KRISCHOMAT/matrix-sq/schematics/matrix-sq-v1.kicad_pcb

## KiCad design schematics/matrix-sq-v1.kicad_pcb (2022-08-06)

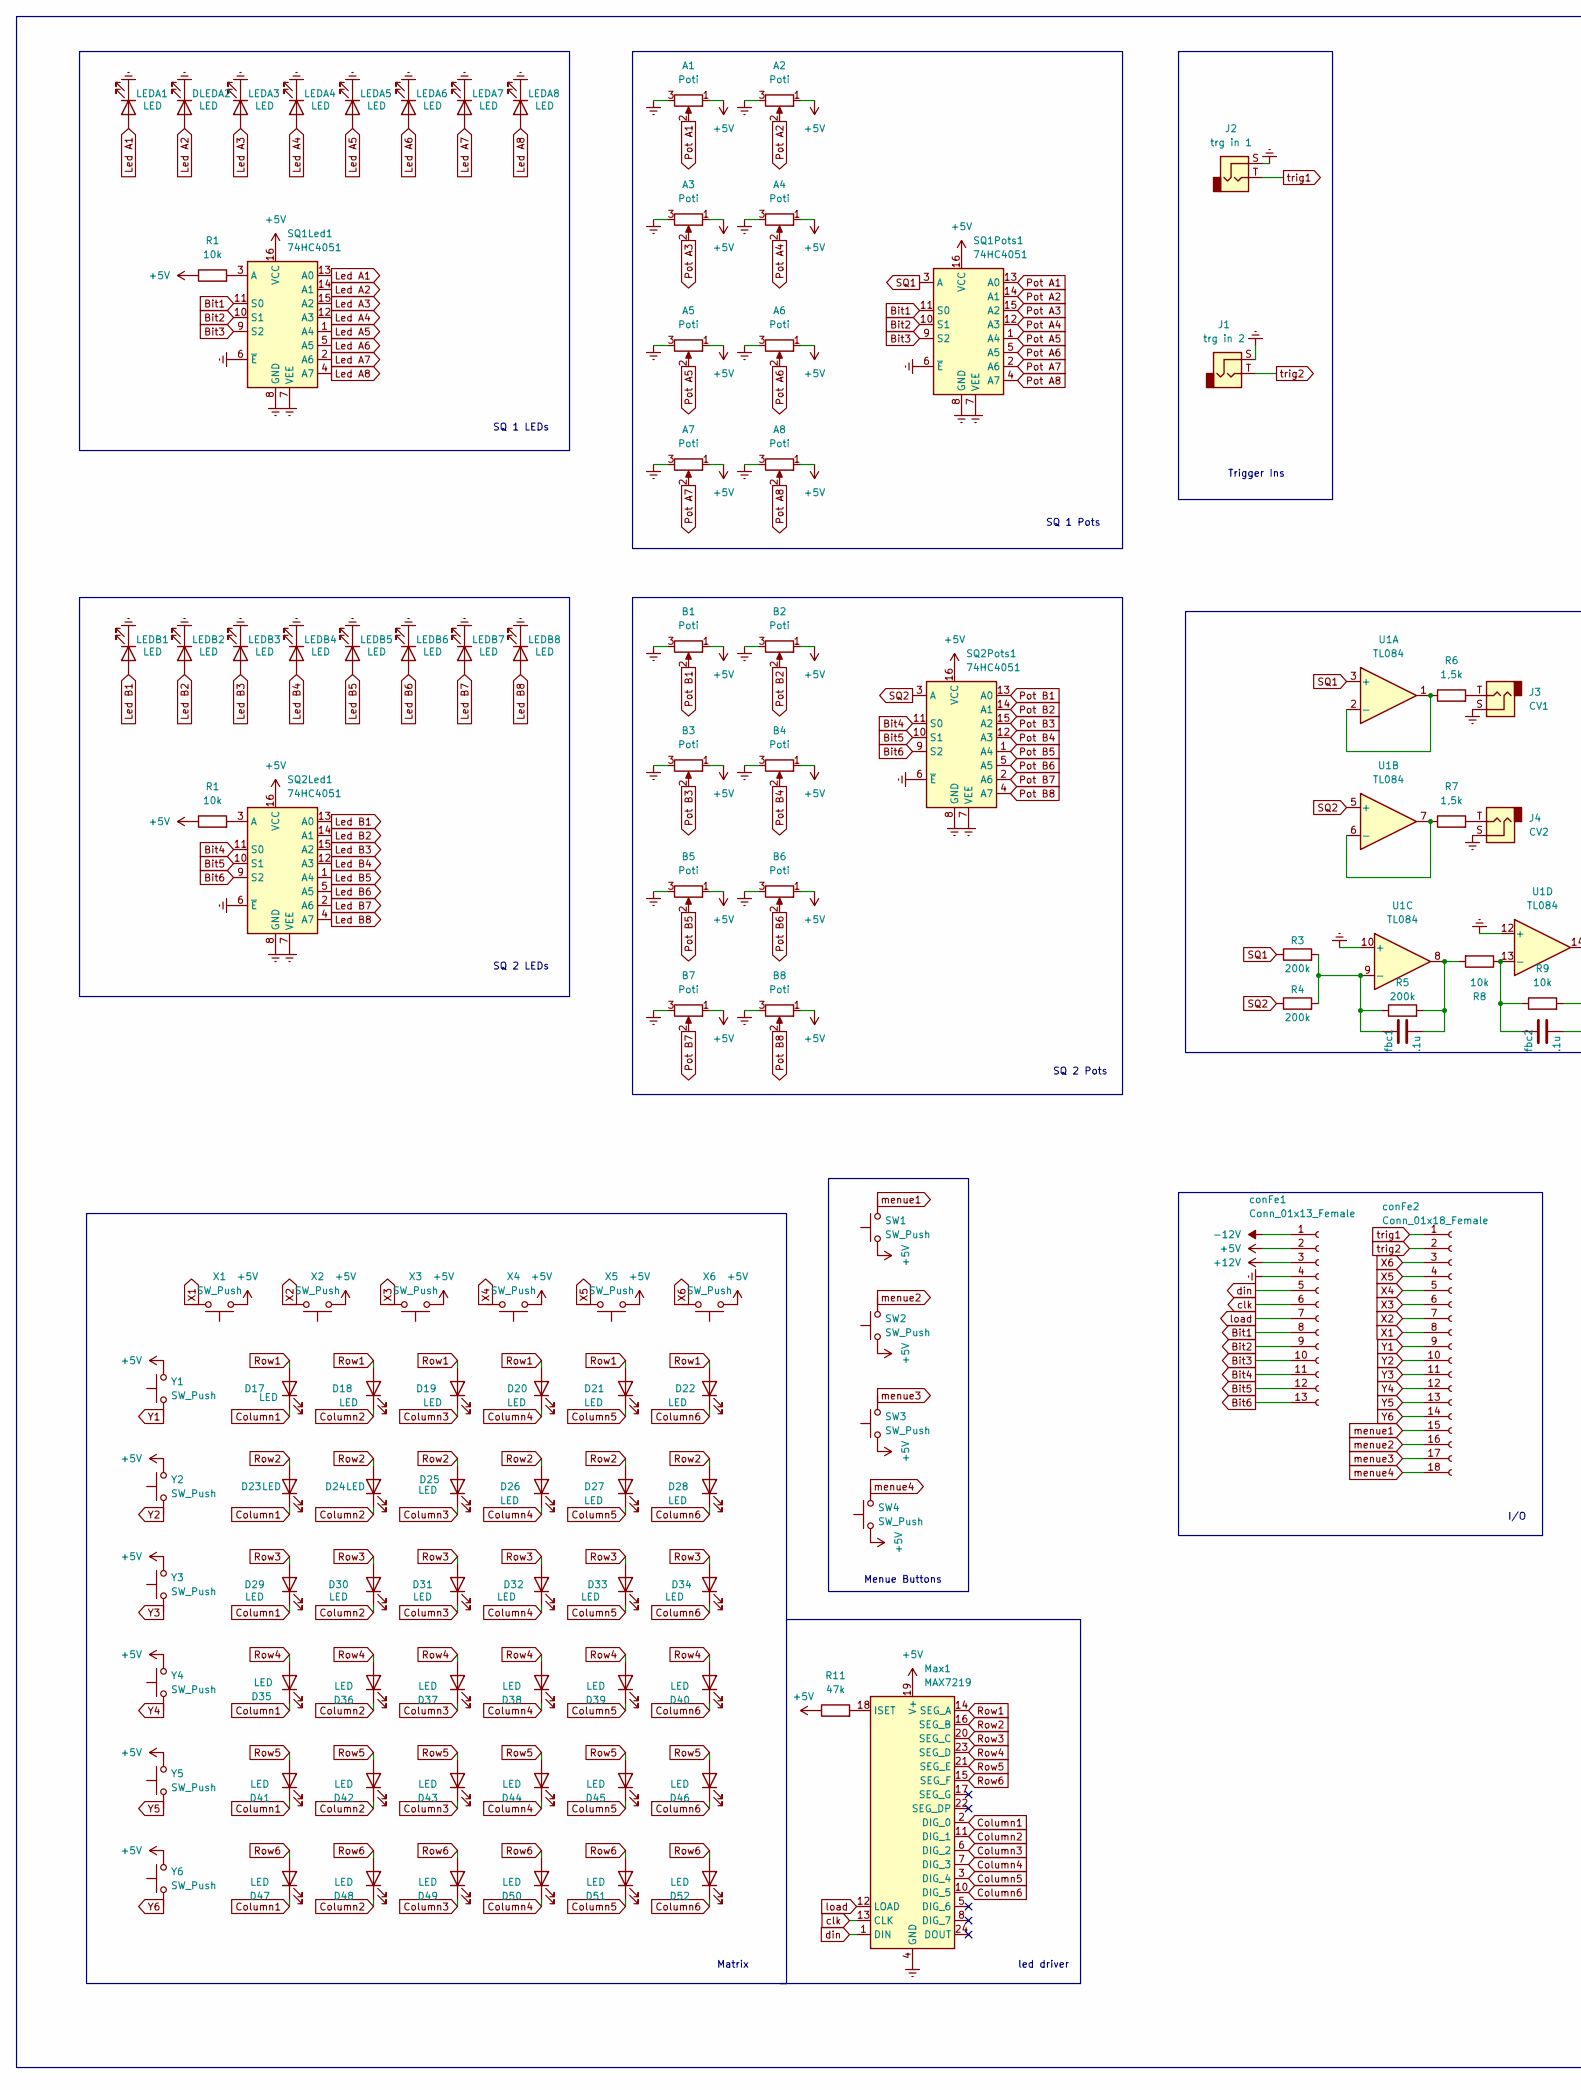
[picture p1: schematic matrix-sq-v1.kicad_sch, part in row 1, column 1]

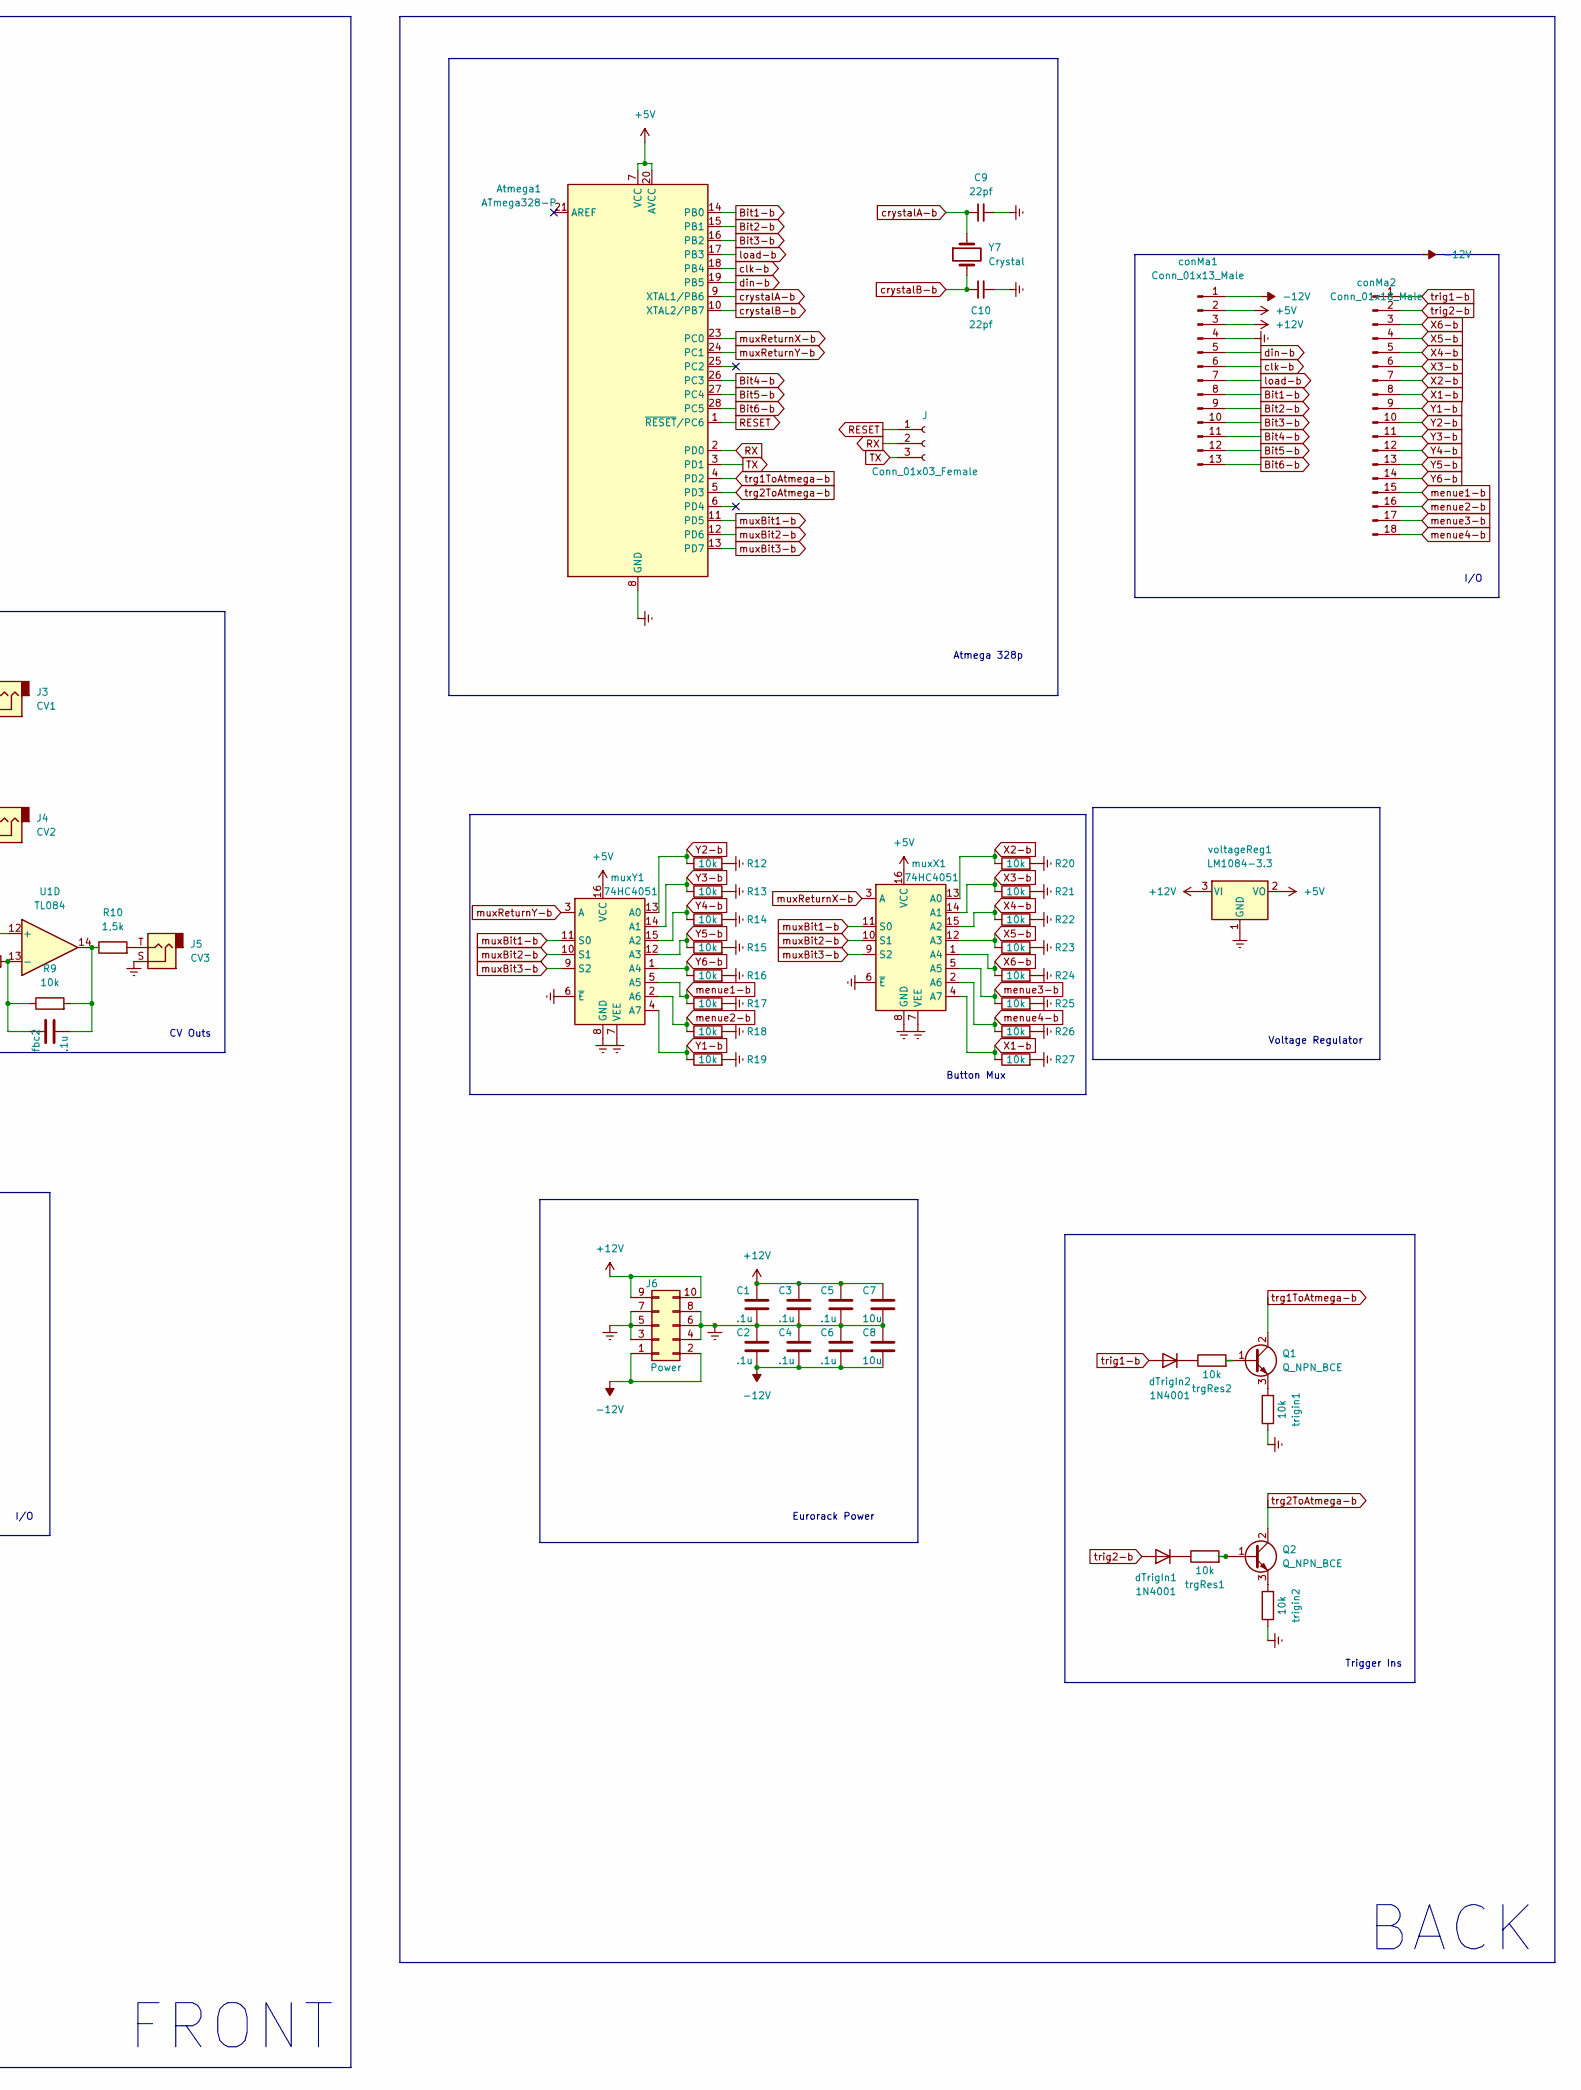
[picture p2: schematic matrix-sq-v1.kicad_sch, part in row 1, column 2]

Parts:
A1, A2, A3, A4, A5, A6, A7, A8: Poti; Potentiometer_Alpha_RD901F-40-00D_Single_Vertical
Atmega1: ATmega328-P; DIP-28_W7.62mm
B1, B2, B3, B4, B5, B6, B7, B8: Poti; Potentiometer_Alpha_RD901F-40-00D_Single_Vertical
C1, C2, C3, C4, C5, C6: .1u; C_Disc_D3.0mm_W1.6mm_P2.50mm
C7, C8: 10u; C_Disc_D3.0mm_W1.6mm_P2.50mm
C9, C10: 22pf; C_Disc_D3.0mm_W1.6mm_P2.50mm
D17, D18, D19, D20, D21, D22, D23, D24, D25, D26, D27, D28, D29, D30, D31, D32, D33, D34, D35, D36, D37, D38, D39, D40, D41, D42, D43, D44, D45, D46, D47, D48, D49, D50, D51, D52: LED; LED_D3.0mm
DLEDA2: LED; LED_D3.0mm
J: Conn_01x03_Female; PinHeader_1x03_P2.54mm_Vertical
J1: trg in 2; Jack_3.5mm_QingPu_WQP-PJ398SM_Vertical_CircularHoles
J2: trg in 1; Jack_3.5mm_QingPu_WQP-PJ398SM_Vertical_CircularHoles
J3: CV1; Jack_3.5mm_QingPu_WQP-PJ398SM_Vertical_CircularHoles
J4: CV2; Jack_3.5mm_QingPu_WQP-PJ398SM_Vertical_CircularHoles
J5: CV3; Jack_3.5mm_QingPu_WQP-PJ398SM_Vertical_CircularHoles
J6: Power; PinHeader_2x05_P2.54mm_Vertical
LEDA1, LEDA3, LEDA4, LEDA5, LEDA6, LEDA7, LEDA8: LED; LED_D3.0mm
LEDB1, LEDB2, LEDB3, LEDB4, LEDB5, LEDB6, LEDB7, LEDB8: LED; LED_D3.0mm
Max1: MAX7219; DIP-24_W7.62mm
Q1, Q2: Q_NPN_BCE; TO-92Flat
R1, R12: R600; R_Axial_DIN0207_L6.3mm_D2.5mm_P7.62mm_Horizontal
R3, R4, R5: 200k; R_Axial_DIN0207_L6.3mm_D2.5mm_P7.62mm_Horizontal
R6, R7, R10: 1,5k; R_Axial_DIN0207_L6.3mm_D2.5mm_P7.62mm_Horizontal
R8, R9, R13, R14, R15, R16, R17, R18, R19, R20, R21, R22, R23, R24, R25, R26, R27: 10k; R_Axial_DIN0207_L6.3mm_D2.5mm_P7.62mm_Horizontal
R11: 47k; R_Axial_DIN0207_L6.3mm_D2.5mm_P7.62mm_Horizontal
SQ1Led1, SQ1Pots1, SQ2Led1, SQ2Pots1: 74HC4051; DIP-16_W7.62mm_Socket
SW1, SW2, SW3, SW4: SW_Push; push_button
U1: TL084; DIP-14_W7.62mm_Socket
X1, X2, X3, X4, X5, X6: SW_Push; push_button
Y1, Y2, Y3, Y4, Y5, Y6: SW_Push; push_button
Y7: Crystal; Crystal_HC18-U_Vertical
conFe1: Conn_01x13_Female; PinHeader_1x13_P2.54mm_Vertical
conFe2: Conn_01x18_Female; PinHeader_1x18_P2.54mm_Vertical
conMa1: Conn_01x13_Male; PinHeader_1x13_P2.54mm_Vertical
conMa2: Conn_01x18_Male; PinSocket_1x18_P2.54mm_Vertical
dTrigIn1, dTrigIn2: 1N4001; D_DO-41_SOD81_P10.16mm_Horizontal
fbc1, fbc2: .1u; C_Disc_D3.0mm_W1.6mm_P2.50mm
muxX1: 74HC4051; DIP-16_W7.62mm_Socket
muxY1: 74HC4051; DIP-16_W7.62mm_Socket
trgRes1, trgRes2: 10k; R_Axial_DIN0207_L6.3mm_D2.5mm_P7.62mm_Horizontal
trigin1, trigin2: 10k; R_Axial_DIN0207_L6.3mm_D2.5mm_P7.62mm_Horizontal
voltageReg1: LM1084-3.3; TO-220-3_Vertical

Connections:
+5V: A1.1, A2.1, A3.1, A4.1, A5.1, A6.1, A7.1, A8.1, Atmega1.7 (VCC), Atmega1.20 (AVCC), B1.1, B2.1, B3.1, B4.1, B5.1, B6.1, B7.1, B8.1, Max1.19 (V+), R1.1, R11.1, SQ1Led1.16 (VCC), SQ1Pots1.16 (VCC), SQ2Led1.16 (VCC), SQ2Pots1.16 (VCC), SW1.1, SW2.1, SW3.1, SW4.1, X1.1, X2.1, X3.1, X4.1, X5.1, X6.1, Y1.2, Y2.2, Y3.2, Y4.2, Y5.2, Y6.2, conFe1.2, conMa1.2, muxX1.16 (VCC), muxY1.16 (VCC), voltageReg1.2 (VO); also elsewhere on the board
+12V: C1.1, C3.1, C5.1, C7.1, J6.9, J6.10, conFe1.3, conMa1.3, voltageReg1.3 (VI)
-12V: C2.2, C4.2, C6.2, C8.2, J6.1, J6.2, conFe1.1, conMa1.1
Bit1: SQ1Led1.11 (S0), SQ1Pots1.11 (S0), conFe1.8
Bit1-b: Atmega1.14 (PB0), conMa1.8
Bit2: SQ1Led1.10 (S1), SQ1Pots1.10 (S1), conFe1.9
Bit2-b: Atmega1.15 (PB1), conMa1.9
Bit3: SQ1Led1.9 (S2), SQ1Pots1.9 (S2), conFe1.10
Bit3-b: Atmega1.16 (PB2), conMa1.10
Bit4: SQ2Led1.11 (S0), SQ2Pots1.11 (S0), conFe1.11
Bit4-b: Atmega1.26 (PC3), conMa1.11
Bit5: SQ2Led1.10 (S1), SQ2Pots1.10 (S1), conFe1.12
Bit5-b: Atmega1.27 (PC4), conMa1.12
Bit6: SQ2Led1.9 (S2), SQ2Pots1.9 (S2), conFe1.13
Bit6-b: Atmega1.28 (PC5), conMa1.13
Column1: D17.1 (K), D23.1 (K), D29.1 (K), D35.1 (K), D41.1 (K), D47.1 (K), Max1.2 (DIG_0)
Column2: D18.1 (K), D24.1 (K), D30.1 (K), D36.1 (K), D42.1 (K), D48.1 (K), Max1.11 (DIG_1)
Column3: D19.1 (K), D25.1 (K), D31.1 (K), D37.1 (K), D43.1 (K), D49.1 (K), Max1.6 (DIG_2)
Column4: D20.1 (K), D26.1 (K), D32.1 (K), D38.1 (K), D44.1 (K), D50.1 (K), Max1.7 (DIG_3)
Column5: D21.1 (K), D27.1 (K), D33.1 (K), D39.1 (K), D45.1 (K), D51.1 (K), Max1.3 (DIG_4)
Column6: D22.1 (K), D28.1 (K), D34.1 (K), D40.1 (K), D46.1 (K), D52.1 (K), Max1.10 (DIG_5)
Earth: A1.3, A2.3, A3.3, A4.3, A5.3, A6.3, A7.3, A8.3, Atmega1.8 (GND), Atmega1.22 (GND), B1.3, B2.3, B3.3, B4.3, B5.3, B6.3, B7.3, B8.3, C1.2, C2.1, C3.2, C4.1, C5.2, C6.1, C7.2, C8.1, C9.2, C10.2, DLEDA2.1 (K), J1.S, J2.S, J3.S, J4.S, J5.S, J6.3, J6.4, J6.5, J6.6, J6.7, J6.8, LEDA1.1 (K), LEDA3.1 (K), LEDA4.1 (K), LEDA5.1 (K), LEDA6.1 (K), LEDA7.1 (K), LEDA8.1 (K), LEDB1.1 (K), LEDB2.1 (K), LEDB3.1 (K), LEDB4.1 (K), LEDB5.1 (K), LEDB6.1 (K), LEDB7.1 (K), LEDB8.1 (K), Max1.4 (GND), Max1.9 (GND), R12.2, R13.2, R14.2, R15.2, R16.2, R17.2, R18.2, R19.2, R20.2, R21.2, R22.2, R23.2, R24.2, R25.2, R26.2, R27.2, SQ1Led1.6 (~E), SQ1Led1.7 (VEE), SQ1Led1.8 (GND), SQ1Pots1.6 (~E), SQ1Pots1.7 (VEE), SQ1Pots1.8 (GND), SQ2Led1.6 (~E), SQ2Led1.7 (VEE), SQ2Led1.8 (GND), SQ2Pots1.6 (~E), SQ2Pots1.7 (VEE), SQ2Pots1.8 (GND), U1.10 (+), U1.12 (+), conFe1.4, conMa1.4, muxX1.6 (~E), muxX1.7 (VEE), muxX1.8 (GND), muxY1.6 (~E), muxY1.7 (VEE), muxY1.8 (GND), trigin1.1, trigin2.1, voltageReg1.1 (GND)
Led A1: LEDA1.2 (A), SQ1Led1.13 (A0)
Led A2: DLEDA2.2 (A), SQ1Led1.14 (A1)
Led A3: LEDA3.2 (A), SQ1Led1.15 (A2)
Led A4: LEDA4.2 (A), SQ1Led1.12 (A3)
Led A5: LEDA5.2 (A), SQ1Led1.1 (A4)
Led A6: LEDA6.2 (A), SQ1Led1.5 (A5)
Led A7: LEDA7.2 (A), SQ1Led1.2 (A6)
Led A8: LEDA8.2 (A), SQ1Led1.4 (A7)
Led B1: LEDB1.2 (A), SQ2Led1.13 (A0)
Led B2: LEDB2.2 (A), SQ2Led1.14 (A1)
Led B3: LEDB3.2 (A), SQ2Led1.15 (A2)
Led B4: LEDB4.2 (A), SQ2Led1.12 (A3)
Led B5: LEDB5.2 (A), SQ2Led1.1 (A4)
Led B6: LEDB6.2 (A), SQ2Led1.5 (A5)
Led B7: LEDB7.2 (A), SQ2Led1.2 (A6)
Led B8: LEDB8.2 (A), SQ2Led1.4 (A7)
unnamed: J3.T, R6.2
unnamed: J4.T, R7.2
unnamed: J5.T, R10.2
unnamed 41: Max1.18 (ISET), R11.2; also elsewhere on the board
unnamed: Q1.1 (B), trgRes2.2
unnamed: Q1.3 (E), trigin1.2
unnamed: Q2.1 (B), trgRes1.2
unnamed: Q2.3 (E), trigin2.2
unnamed: R3.2, R4.2, R5.1, U1.9 (-), fbc1.1
unnamed: R5.2, R8.2, U1.8, fbc1.2
unnamed: R6.1, U1.1, U1.2 (-)
unnamed: R7.1, U1.6 (-), U1.7
unnamed: R8.1, R9.1, U1.13 (-), fbc2.1
unnamed: R9.2, R10.1, U1.14, fbc2.2
unnamed: dTrigIn1.1 (K), trgRes1.1
unnamed: dTrigIn2.1 (K), trgRes2.1
Pot A1: A1.2, SQ1Pots1.13 (A0)
Pot A2: A2.2, SQ1Pots1.14 (A1)
Pot A3: A3.2, SQ1Pots1.15 (A2)
Pot A4: A4.2, SQ1Pots1.12 (A3)
Pot A5: A5.2, SQ1Pots1.1 (A4)
Pot A6: A6.2, SQ1Pots1.5 (A5)
Pot A7: A7.2, SQ1Pots1.2 (A6)
Pot A8: A8.2, SQ1Pots1.4 (A7)
Pot B1: B1.2, SQ2Pots1.13 (A0)
Pot B2: B2.2, SQ2Pots1.14 (A1)
Pot B3: B3.2, SQ2Pots1.15 (A2)
Pot B4: B4.2, SQ2Pots1.12 (A3)
Pot B5: B5.2, SQ2Pots1.1 (A4)
Pot B6: B6.2, SQ2Pots1.5 (A5)
Pot B7: B7.2, SQ2Pots1.2 (A6)
Pot B8: B8.2, SQ2Pots1.4 (A7)
RESET: Atmega1.1 (~RESET/PC6), J.1
RX: Atmega1.2 (PD0), J.2
Row1: D17.2 (A), D18.2 (A), D19.2 (A), D20.2 (A), D21.2 (A), D22.2 (A), Max1.14 (SEG_A)
Row2: D23.2 (A), D24.2 (A), D25.2 (A), D26.2 (A), D27.2 (A), D28.2 (A), Max1.16 (SEG_B)
Row3: D29.2 (A), D30.2 (A), D31.2 (A), D32.2 (A), D33.2 (A), D34.2 (A), Max1.20 (SEG_C)
Row4: D35.2 (A), D36.2 (A), D37.2 (A), D38.2 (A), D39.2 (A), D40.2 (A), Max1.23 (SEG_D)
Row5: D41.2 (A), D42.2 (A), D43.2 (A), D44.2 (A), D45.2 (A), D46.2 (A), Max1.21 (SEG_E)
Row6: D47.2 (A), D48.2 (A), D49.2 (A), D50.2 (A), D51.2 (A), D52.2 (A), Max1.15 (SEG_F)
SQ1: R3.1, SQ1Pots1.3 (A), U1.3 (+)
SQ2: R4.1, SQ2Pots1.3 (A), U1.5 (+)
TX: Atmega1.3 (PD1), J.3
X1: X1.2, conFe2.8
X1-b: R27.1, conMa2.8, muxX1.4 (A7)
X2: X2.2, conFe2.7
X2-b: R20.1, conMa2.7, muxX1.13 (A0)
X3: X3.2, conFe2.6
X3-b: R21.1, conMa2.6, muxX1.14 (A1)
X4: X4.2, conFe2.5
X4-b: R22.1, conMa2.5, muxX1.15 (A2)
X5: X5.2, conFe2.4
X5-b: R23.1, conMa2.4, muxX1.12 (A3)
X6: X6.2, conFe2.3
X6-b: R24.1, conMa2.3, muxX1.1 (A4)
Y1: Y1.1, conFe2.9
Y1-b: R19.1, conMa2.9, muxY1.4 (A7)
Y2: Y2.1, conFe2.10
Y2-b: R12.1, conMa2.10, muxY1.13 (A0)
Y3: Y3.1, conFe2.11
Y3-b: R13.1, conMa2.11, muxY1.14 (A1)
Y4: Y4.1, conFe2.12
Y4-b: R14.1, conMa2.12, muxY1.15 (A2)
Y5: Y5.1, conFe2.13
Y5-b: R15.1, conMa2.13, muxY1.12 (A3)
Y6: Y6.1, conFe2.14
Y6-b: R16.1, conMa2.14, muxY1.1 (A4)
clk: Max1.13 (CLK), conFe1.6
clk-b: Atmega1.18 (PB4), conMa1.6
crystalA-b: Atmega1.9 (XTAL1/PB6), C9.1, Y7.1
crystalB-b: Atmega1.10 (XTAL2/PB7), C10.1, Y7.2
din: Max1.1 (DIN), conFe1.5
din-b: Atmega1.19 (PB5), conMa1.5
load: Max1.12 (LOAD), conFe1.7
load-b: Atmega1.17 (PB3), conMa1.7
menue1: SW1.2, conFe2.15
menue1-b: R17.1, conMa2.15, muxY1.5 (A5)
menue2: SW2.2, conFe2.16
menue2-b: R18.1, conMa2.16, muxY1.2 (A6)
menue3: SW3.2, conFe2.17
menue3-b: R25.1, conMa2.17, muxX1.5 (A5)
menue4: SW4.2, conFe2.18
menue4-b: R26.1, conMa2.18, muxX1.2 (A6)
muxBit1-b: Atmega1.11 (PD5), muxX1.11 (S0), muxY1.11 (S0)
muxBit2-b: Atmega1.12 (PD6), muxX1.10 (S1), muxY1.10 (S1)
muxBit3-b: Atmega1.13 (PD7), muxX1.9 (S2), muxY1.9 (S2)
muxReturnX-b: Atmega1.23 (PC0), muxX1.3 (A)
muxReturnY-b: Atmega1.24 (PC1), muxY1.3 (A)
trg1ToAtmega-b: Atmega1.4 (PD2), Q1.2 (C)
trg2ToAtmega-b: Atmega1.5 (PD3), Q2.2 (C)
trig1: J2.T, conFe2.1
trig1-b: conMa2.1, dTrigIn2.2 (A)
trig2: J1.T, conFe2.2
trig2-b: conMa2.2, dTrigIn1.2 (A)

Notes on the sheet:
BACK
Voltage Regulator
SQ 2 Pots
led driver
Trigger Ins
FRONT
SQ 1 Pots
Eurorack Power
SQ 2 LEDs
Matrix
Atmega 328p
Button Mux
I/O
CV Outs
Menue Buttons
SQ 1 LEDs

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
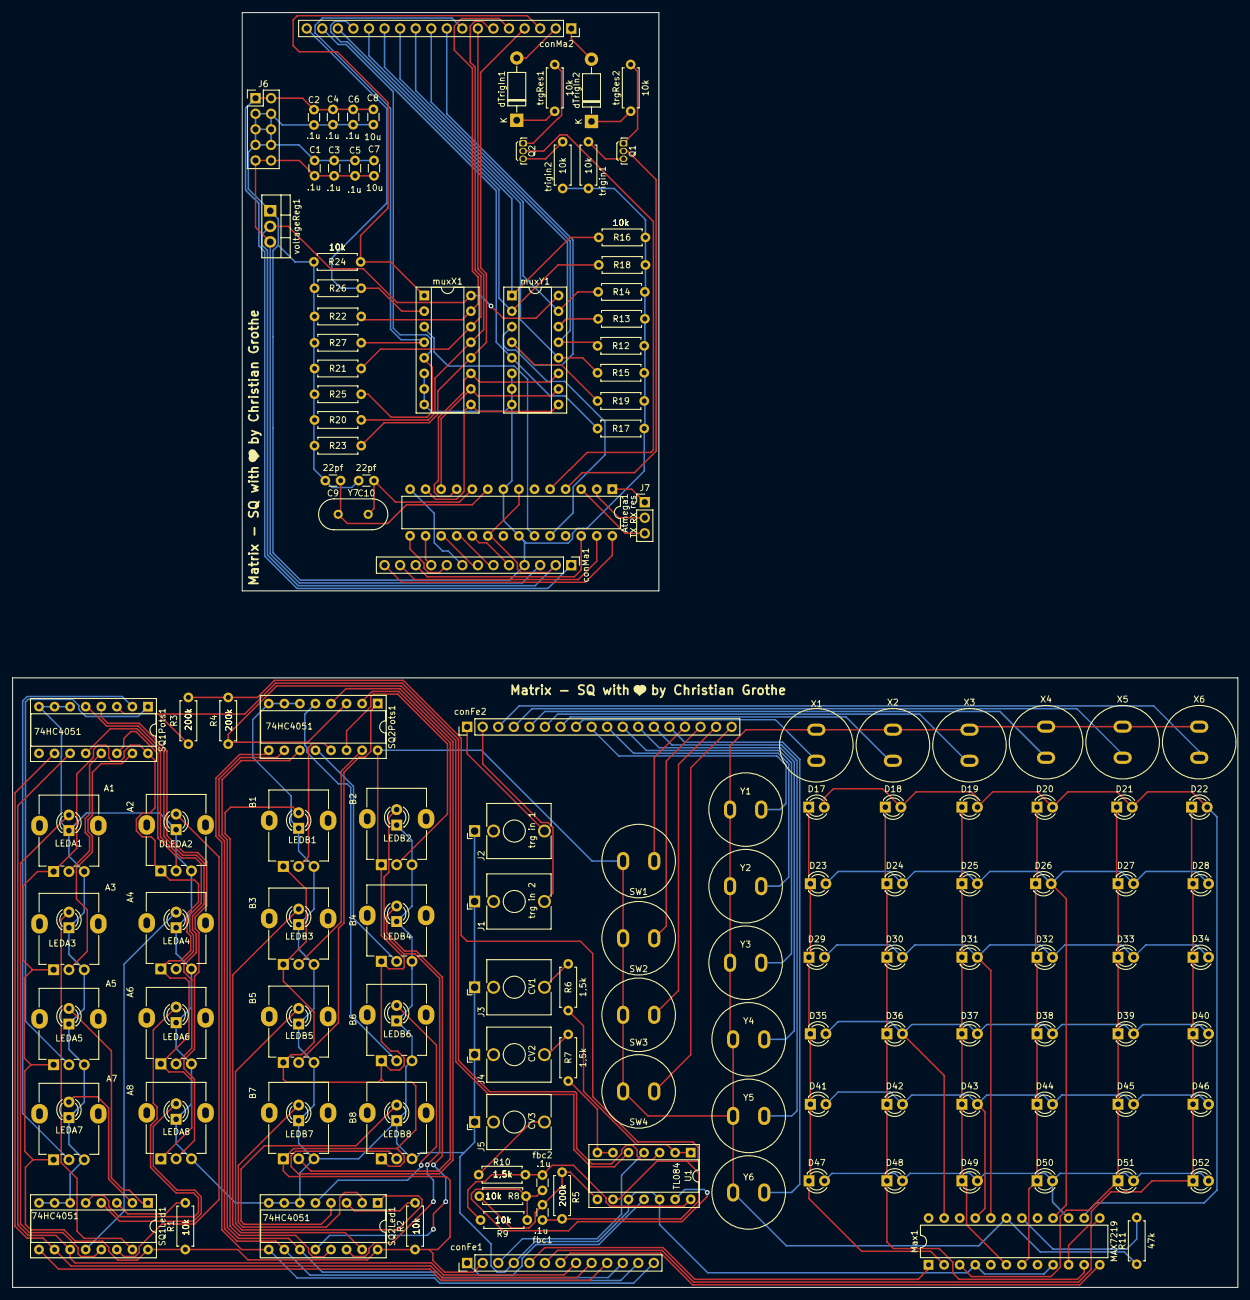
[picture p3: board matrix-sq-v1.kicad_pcb from above]

Board: 2 copper layers, 200.0 x 208.1 mm, 153 parts (0 on the bottom side), 134 nets.

Other parts of the board:
R1#2: R600; R_Axial_DIN0207_L6.3mm_D2.5mm_P7.62mm_Horizontal
R?: 47k; R_Axial_DIN0207_L6.3mm_D2.5mm_P7.62mm_Horizontal

Their connections:
+5V: R1#2.1, R?.1; also elsewhere on the board
unnamed 41: R?.2; also elsewhere on the board
