KRISCHOMAT/matrix-sq/(commit log)

2022-07-04 init commit
    [matrix-sq-v1.kicad_pcb, matrix-sq-v1.kicad_sch]
2022-07-05 front PCB
    [matrix-sq-v1.kicad_pcb, matrix-sq-v1.kicad_sch]
2022-07-06 pcb front and fill
    [matrix-sq-v1.kicad_pcb, matrix-sq-v1.kicad_sch]
2022-07-06 front & backfile, gerber
    [back-B_Cu.gbl, back-B_Mask.gbs, back-B_Paste.gbp, back-B_Silkscreen.gbo, back-Edge_Cuts.gm1, back-F_Cu.gtl, back-F_Mask.gts, back-F_Paste.gtp]
2022-07-06 refactor front-gerber
    [front-B_Cu.gbl, front-B_Mask.gbs, front-B_Paste.gbp, front-B_Silkscreen.gbo, front-Edge_Cuts.gm1, front-F_Cu.gtl, front-F_Mask.gts, front-F_Paste.gtp]
2022-07-06 edge cuts
    [back.kicad_pcb, front.kicad_pcb, matrix-sq-v1.kicad_pcb]
2022-07-07 new header footprints
    [back-B_Cu.gbl, back-B_Mask.gbs, back-B_Paste.gbp, back-B_Silkscreen.gbo, back-Edge_Cuts.gm1, back-F_Cu.gtl, back-F_Mask.gts, back-F_Silkscreen.gto]
2022-07-07 clean up
    [matrix-sq-v1.kicad_pcb]
2022-08-06 refactor 6.8.
    [matrix-sq-v1.kicad_pcb, matrix-sq-v1.kicad_sch]
2022-08-06 renew gerber
    [matrix-sq-v1-B_Cu.gbl, matrix-sq-v1-B_Mask.gbs, matrix-sq-v1-B_Paste.gbp, matrix-sq-v1-B_Silkscreen.gbo, matrix-sq-v1-Edge_Cuts.gm1, matrix-sq-v1-F_Cu.gtl, matrix-sq-v1-F_Mask.gts, matrix-sq-v1-F_Paste.gtp]
